jaynathan2021/ECE-482-FullCustom-ImageComparator-VLSI/all2/clk_inverter/layout/thumbnail_128x128.png

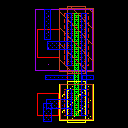
all2/clk_inverter/layout/thumbnail_128x128.png
