jaynathan2021/ECE-482-FullCustom-ImageComparator-VLSI/all2/DregX/symbol/thumbnail_128x128.png

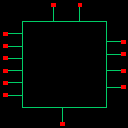
all2/DregX/symbol/thumbnail_128x128.png
