jaynathan2021/ECE-482-FullCustom-ImageComparator-VLSI/all2/Half_adder/schematic/thumbnail_128x128.png

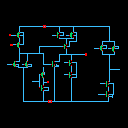
all2/Half_adder/schematic/thumbnail_128x128.png
