jaynathan2021/ECE-482-FullCustom-ImageComparator-VLSI/all2/superbuffer/symbol/thumbnail_128x128.png

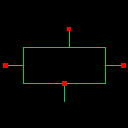
all2/superbuffer/symbol/thumbnail_128x128.png
