jaynathan2021/ECE-482-FullCustom-ImageComparator-VLSI/all2/xora1/layout/thumbnail_128x128.png

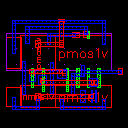
all2/xora1/layout/thumbnail_128x128.png
