jaynathan2021/ECE-482-FullCustom-ImageComparator-VLSI/Piso/D_reg/schematic/thumbnail_128x128.png

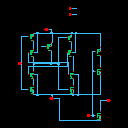
Piso/D_reg/schematic/thumbnail_128x128.png
