jaynathan2021/ECE-482-FullCustom-ImageComparator-VLSI/Piso/D_reg/symbol/thumbnail_128x128.png

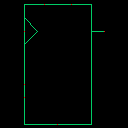
Piso/D_reg/symbol/thumbnail_128x128.png
