jaynathan2021/ECE-482-FullCustom-ImageComparator-VLSI/Piso/Dreg/4frequencydivider/layout/thumbnail_128x128.png

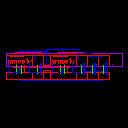
Piso/Dreg/4frequencydivider/layout/thumbnail_128x128.png
