jaynathan2021/ECE-482-FullCustom-ImageComparator-VLSI/Piso/Dreg/D_reg4/layout/thumbnail_128x128.png

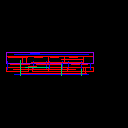
Piso/Dreg/D_reg4/layout/thumbnail_128x128.png
