jaynathan2021/ECE-482-FullCustom-ImageComparator-VLSI/Piso/Dreg/integrated/layout/thumbnail_128x128.png

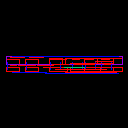
Piso/Dreg/integrated/layout/thumbnail_128x128.png
