jaynathan2021/ECE-482-FullCustom-ImageComparator-VLSI/Piso/Inverter/layout/thumbnail_128x128.png

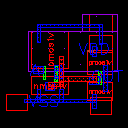
Piso/Inverter/layout/thumbnail_128x128.png
