jaynathan2021/ECE-482-FullCustom-ImageComparator-VLSI/Piso/Inverter/schematic/thumbnail_128x128.png

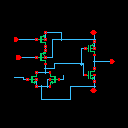
Piso/Inverter/schematic/thumbnail_128x128.png
