jaynathan2021/ECE-482-FullCustom-ImageComparator-VLSI/Piso/Inverter/symbol/thumbnail_128x128.png

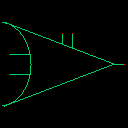
Piso/Inverter/symbol/thumbnail_128x128.png
