jaynathan2021/ECE-482-FullCustom-ImageComparator-VLSI/Piso/Mux/layout/thumbnail_128x128.png

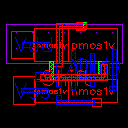
Piso/Mux/layout/thumbnail_128x128.png
