jaynathan2021/ECE-482-FullCustom-ImageComparator-VLSI/Piso/Mux/schematic/thumbnail_128x128.png

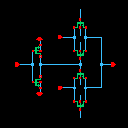
Piso/Mux/schematic/thumbnail_128x128.png
