jaynathan2021/ECE-482-FullCustom-ImageComparator-VLSI/Piso/Mux/symbol/thumbnail_128x128.png

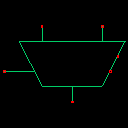
Piso/Mux/symbol/thumbnail_128x128.png
