jaynathan2021/ECE-482-FullCustom-ImageComparator-VLSI/Piso/OR_gate/symbol/thumbnail_128x128.png

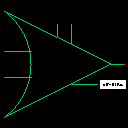
Piso/OR_gate/symbol/thumbnail_128x128.png
