jaynathan2021/ECE-482-FullCustom-ImageComparator-VLSI/Piso/Piso_v2/layout/thumbnail_128x128.png

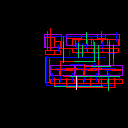
Piso/Piso_v2/layout/thumbnail_128x128.png
