jaynathan2021/ECE-482-FullCustom-ImageComparator-VLSI/subckt.cir

.SUBCKT PIPO_and_Combinational clk rst xin0 xin1 xin2 xin3 yin0 yin1 yin2 yin3 vddio r_out vdd vss


c1 vdd vss 1.05148e-15
c2 clk vss 169.772e-18
c3 rst vss 208.837e-18
c4 r_out vss 36.4081e-18
c5 vddio vss 49.3446e-18
c6 xin0 vss 47.6761e-18
c7 xin1 vss 53.9727e-18
c8 xin2 vss 57.9603e-18
c9 xin3 vss 60.8749e-18
c10 yin0 vss 43.5999e-18
c11 yin1 vss 49.5315e-18
c12 yin2 vss 51.5228e-18
c13 yin3 vss 60.2306e-18
c14 clk4 vss 27.1014e-18
c15 clk4b vss 95.3554e-18
c16 clkb vss 216.414e-18
c17 clk2 vss 25.8153e-18
c18 x0 vss 40.1396e-18
c19 x1 vss 40.2644e-18
c20 x2 vss 44.6484e-18
c21 x3 vss 47.1718e-18
c22 y0 vss 53.7371e-18
c23 y1 vss 53.4488e-18
c24 y2 vss 55.5271e-18
c25 y3 vss 55.321e-18
c26 net12 vss 92.2494e-18
c27 c1 vss 51.9719e-18
c28 c0 vss 51.689e-18
c29 r2 vss 74.4362e-18
c30 r1 vss 68.8447e-18
c31 a0 vss 104.934e-18
c32 a1 vss 55.9119e-18
c33 s0 vss 50.178e-18
c34 s1 vss 56.6335e-18
c35 r0 vss 141.399e-18
c36 a2 vss 103.688e-18
c37 a3 vss 55.4149e-18
c38 serial_out vss 105.736e-18
c39 i12__net3 vss 59.6419e-18
c40 i6__net3 vss 129.969e-18
c41 net5 vss 112.682e-18
c42 r_in vss 108.714e-18
c43 i12__net1 vss 62.8924e-18
c44 i12__net2 vss 58.5464e-18
c45 i11__net1 vss 108.186e-18
c46 i6__net2 vss 110.307e-18
c47 i6__abar vss 69.1677e-18
c48 i6__net4 vss 95.9298e-18
c49 i6__bbar vss 65.3991e-18
c50 i6__net1 vss 117.199e-18
c51 i5__net3 vss 135.29e-18
c52 i5__net2 vss 107.96e-18
c53 i5__abar vss 68.4173e-18
c54 i5__net4 vss 95.2949e-18
c55 i5__bbar vss 67.3721e-18
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
c894 n14__clk4b vss 115.02e-18
c895 n2__xin1 vss 82.0902e-18
c896 n2__yin1 vss 35.3982e-18
c897 n15__clk4 vss 47.8353e-18
c898 n11__clk4b vss 92.5429e-18
c899 n13__clk4 vss 47.3713e-18
c900 n9__clk4b vss 92.6171e-18
c901 n4__i1__rstb vss 20.2174e-18
c902 n4__i2__rstb vss 20.6143e-18
c903 n2__i1__rstb vss 50.765e-18
c904 n2__i2__rstb vss 49.5075e-18
c905 n6__y0 vss 69.4244e-18
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
